michaellangford99/Indiana-Tech-Explorer-Post-2829-2017-Lightweight-Sumo/schematic-1.jpg

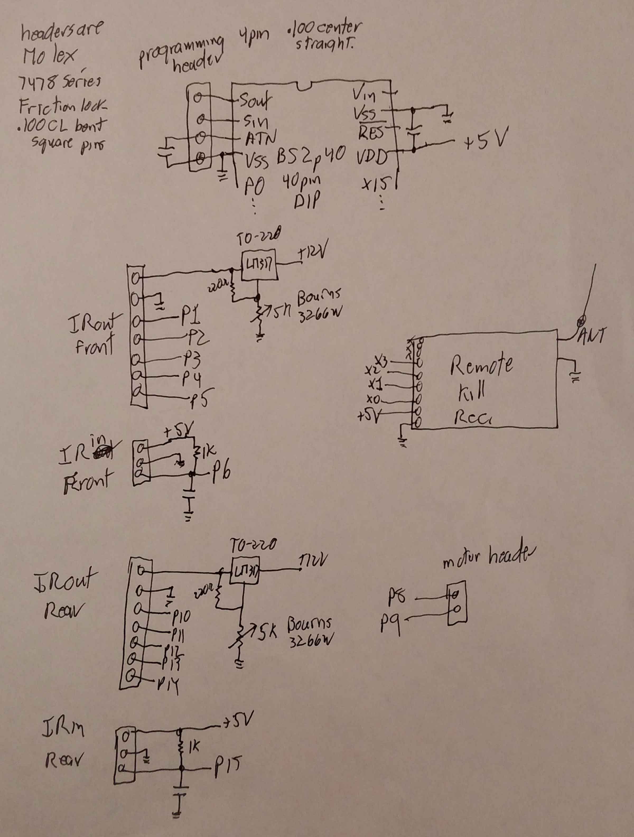
schematic-1.jpg
