michaellangford99/Indiana-Tech-Explorer-Post-2829-2017-Lightweight-Sumo/BS2P40.jpg

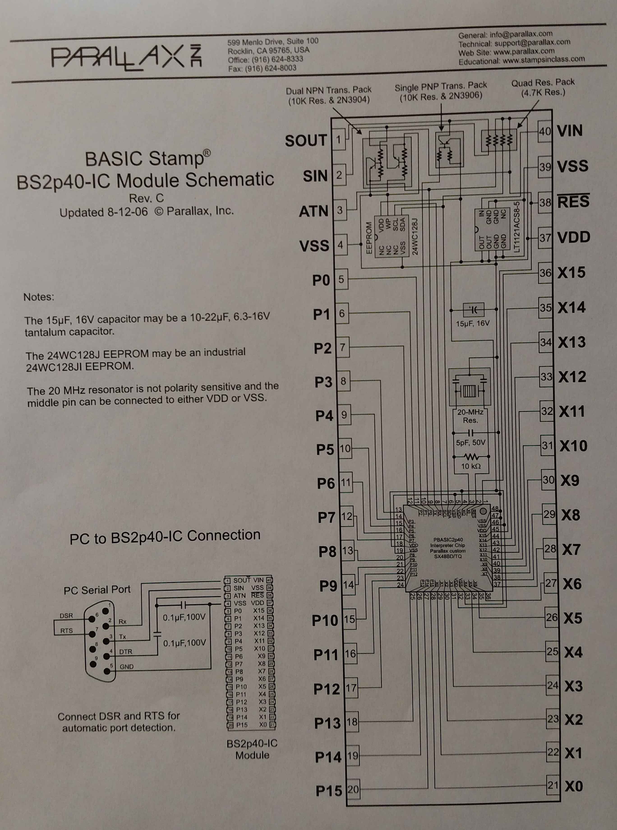
BS2P40.jpg
