michaellangford99/Indiana-Tech-Explorer-Post-2829-2017-Lightweight-Sumo/README.md

# Indiana-Tech-Explorer-Post-2829-2017-Lightweight-Sumo
