michaellangford99/Indiana-Tech-Explorer-Post-2829-2017-Lightweight-Sumo/PCB/Lightweight_Sumo PDF - 1 all layers.pdf

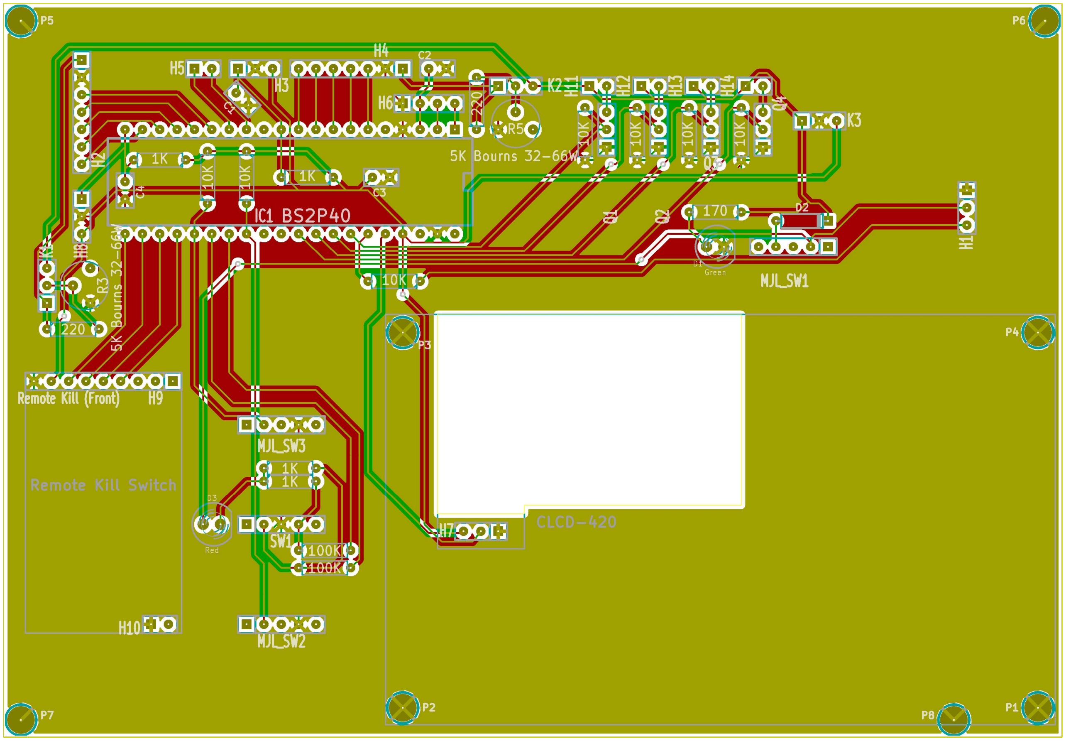
[picture p3: figure]
