michaellangford99/Indiana-Tech-Explorer-Post-2829-2017-Lightweight-Sumo/Pins.jpg

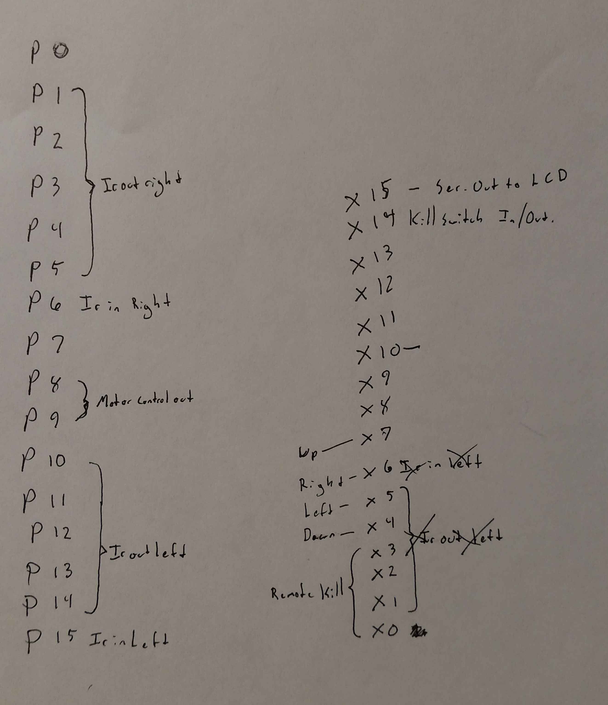
Pins.jpg
