michaellangford99/Indiana-Tech-Explorer-Post-2829-2017-Lightweight-Sumo/Schematic-2.jpg

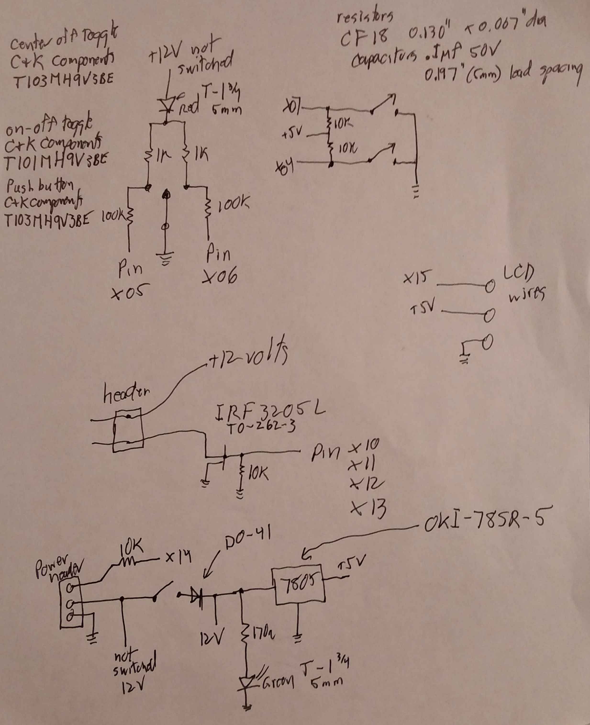
Schematic-2.jpg
