michaellangford99/Indiana-Tech-Explorer-Post-2829-2017-Lightweight-Sumo/(commit log)

2017-01-18 Added Experimental code folder for use with two sensored plows
2017-01-18 Added board images
2017-01-18 commented out dangerous Kill switch code
2017-01-18 Added Printed Circuit Board design files
    [Lightweight_Sumo-B_Cu.gbl, Lightweight_Sumo-B_Mask.gbs, Lightweight_Sumo-B_Paste.gbp, Lightweight_Sumo-B_SilkS.gbo, Lightweight_Sumo-Edge_Cuts.gbr, Lightweight_Sumo-F_Cu.gtl, Lightweight_Sumo-F_Mask.gts, Lightweight_Sumo-F_Paste.gtp]
2017-01-19 Working on adding Back sensor code - the header has also changed
2017-01-19 Completed first version of dual sensor code.
    Motor routines are still the same, but motor control code
    switches motor direction when in Back Sensor Mode
2017-01-19 Fixed DEBUG printout of IR values
2017-01-19 Added weights to different sensor hits
    This makes the sumo change direction less readily
2017-01-20 Changed the way direction is switched
    A counter is increased when hits have been recieved on the opposite side
    and no hits are recieved on the current side. When the counter reaches a
    set max, the direction is changed and the counter is zeroed
2017-01-23 new Back-To-Back Charge routine, new reset code, gets direction from EEPROM
2017-01-23 Removed motor value flipping, made each direction's motor routines unique
2017-01-23 Added display routine that prints debug info to LCD
2017-03-02 added LED code
2017-03-02 Added test for front and back sensors
2017-03-02 Updated display text for kill switch routine
2017-03-03 tidied up LED code, made IR Start work for both front and back sensors
2017-03-03 Added LED helper functions - kill switch code also turns on green LED
2017-03-31 fixed sensor problems with pause in between sensor readings
2017-04-01 reduced code size, fixed direction bit error, created uniform variable space, fixed pin problems
2018-01-24 fixed spelling error in comment, added call to sensors in Kill, put IR constants at top
2018-01-24 1st revision operating PID loop with side switching
2018-01-24 Completed 1st revision full PID loop code
2018-01-26 Added code to initially blind sensors at start of routine to prevent IR remote from forcing it out of start routine also tuned routines
2018-01-26 new test code for LEDs, plus PID loop test code
2018-01-26 added comment to explain reasoning behind initial blinding of sensors during start routine
2018-04-07 Renamed start routines, enabled IR Start, added EEPROM write functionality for program switches, trimmed LCD display function
